drunken-octopus/ao-usb-drive-reader-rev-c/KiCad_Files/USB_Reader_Rev_C.png

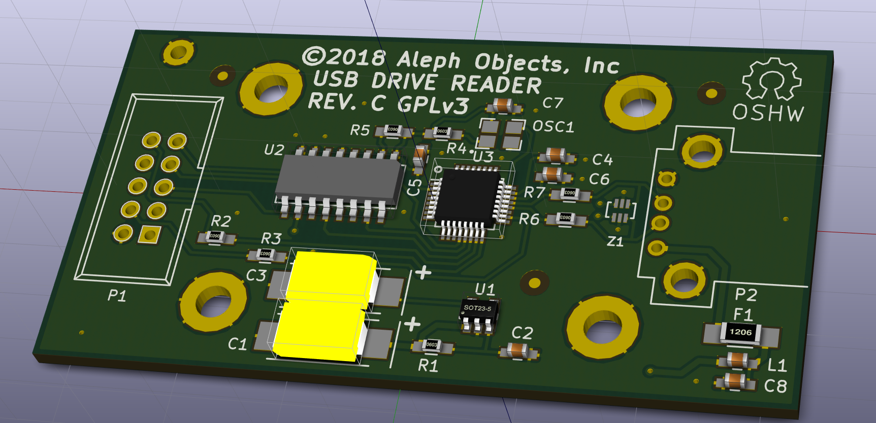
KiCad_Files/USB_Reader_Rev_C.png
