drunken-octopus/ao-usb-drive-reader-rev-c/USB_Reader_Rev_C.pdf

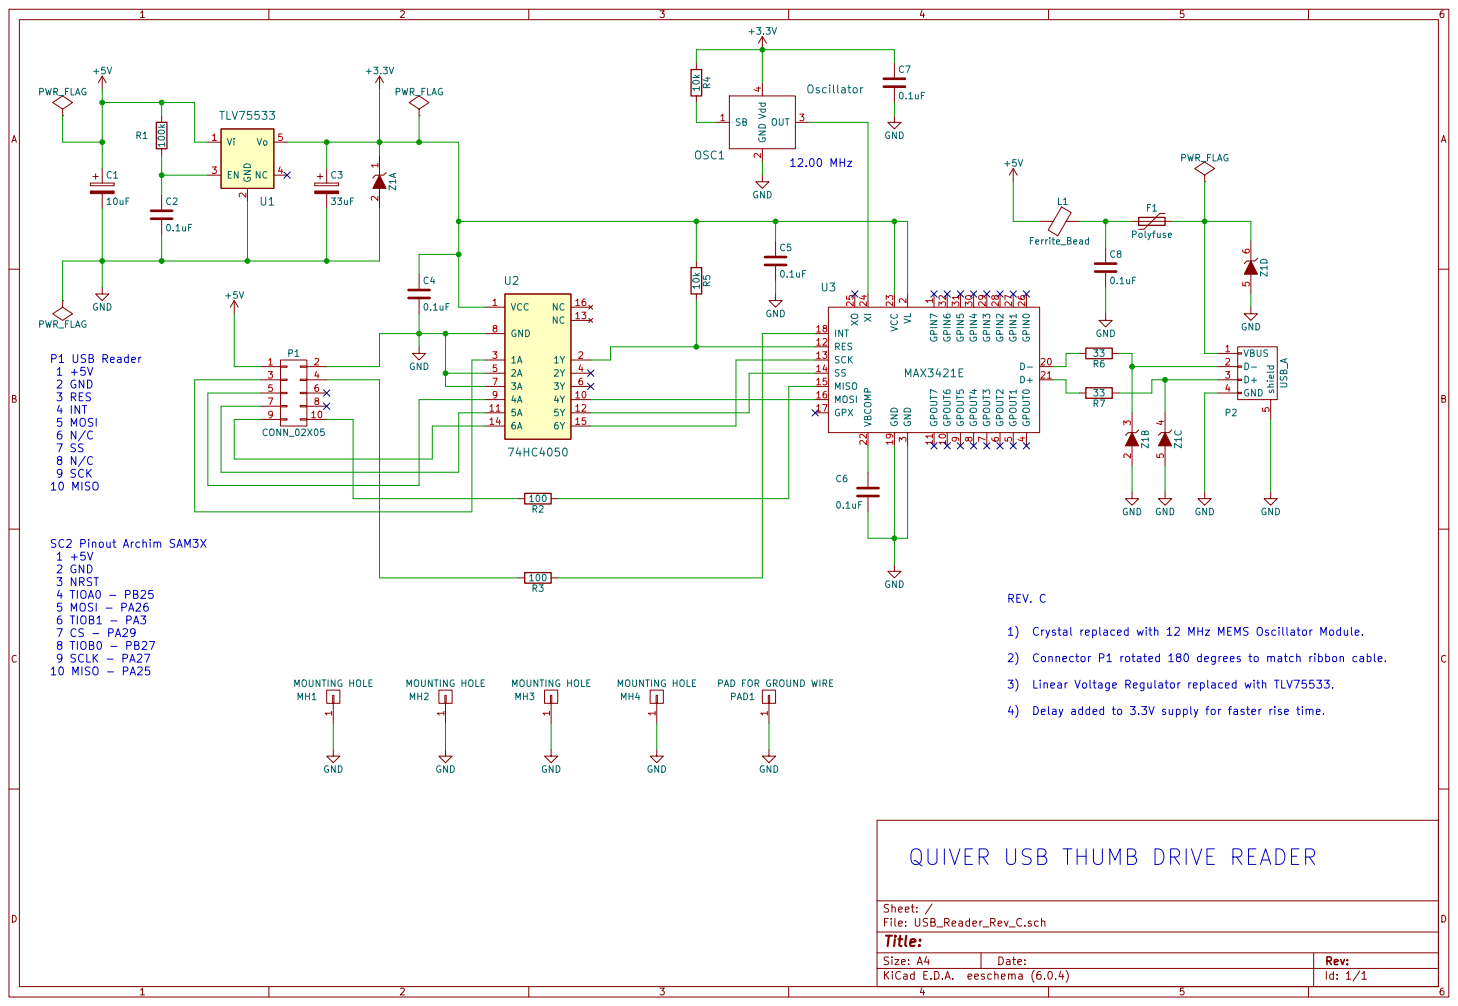
[picture p2: page 1]

1 GPOUT6 10 GPOUT7 11 RES 12 SCK 13 SS 14 MISO 15 MOSI 16 GPX 17

2 D- 20 D+ 21 VBCOMP 22 VCC 23 XI 24 XO 25 GPIN0 26 GPIN1 27 GPIN2 28 GPIN3 29 GND

3A 7 GND 8 1A 3

1 MH1 MOUNTING HOLE GND GND

1 PAD1 PAD FOR GROUND WIRE C6

1) Crystal replaced with 12 MHz MEMS Oscillator Module.

2) Connector P1 rotated 180 degrees to match ribbon cable.

3) Linear Voltage Regulator replaced with TLV75533.

4) Delay added to 3.3V supply for faster rise time.

QUIVER USB THUMB DRIVE READER
