drunken-octopus/ao-usb-drive-reader-rev-c/KiCad_Files/USB_Reader_Rev_C.kicad_pcb

## KiCad design KiCad_Files/USB_Reader_Rev_C.kicad_pcb (2019-01-10)

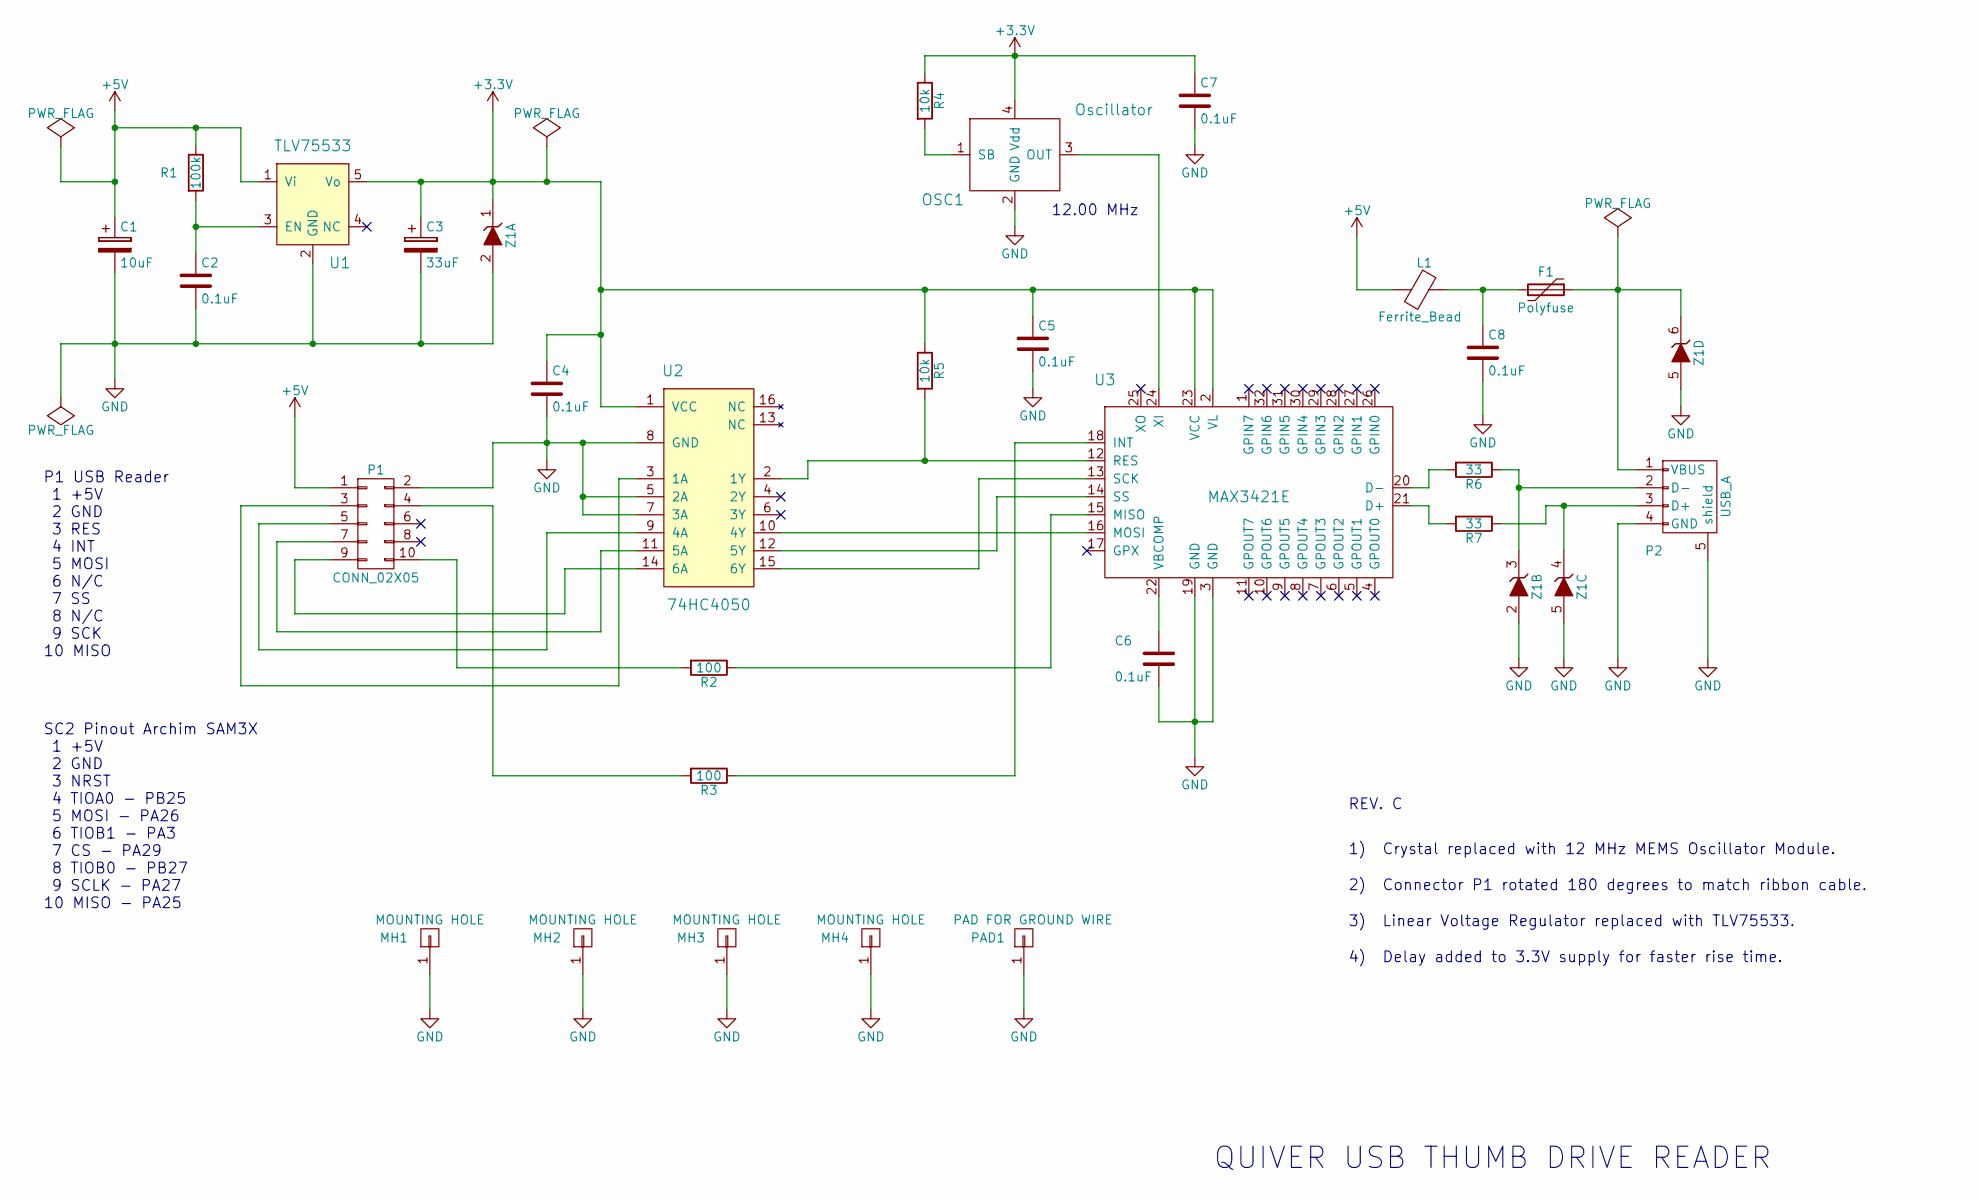
[picture p3: schematic USB_Reader_Rev_C.sch]

Parts:
C1: 10uF; TantalC_SizeD_EIA-7343_HandSoldering
C2, C4, C5, C6, C7, C8: 0.1uF; C_0603_HandSoldering
C3: 33uF; TantalC_SizeD_EIA-7343_HandSoldering
F1: Polyfuse; R_1206_HandSoldering
L1: Ferrite_Bead; C_0603_HandSoldering
MH1, MH2, MH3, MH4: MOUNTING HOLE; MH_M3x6mm
OSC1: Oscillator; FA-328_Crystal
P1: CONN_02X05; IDC_Header_Straight_10pins
P2: USB_A; USB_A_TH
PAD1: PAD FOR GROUND WIRE; GND_PAD
R1: 100k; R_0603_HandSoldering
R2, R3: 100; R_0603_HandSoldering
R4, R5: 10k; R_0603_HandSoldering
R6, R7: 33; R_0603_HandSoldering
U1: TLV75533; SOT-23-5
U2: 74HC4050; SO-16-N
U3: MAX3421E; LQFP-32_5x5mm_Pitch0.5mm
Z1: ZENER_4_CHANNEL; SOT-666

Connections:
+3V3: C3.1, C4.1, C5.1, C7.1, OSC1.4 (Vdd), R4.1, R5.1, U1.5 (Vo), U2.1 (VCC), U3.2 (VL), U3.23 (VCC), Z1.1 (K)
+5V: C1.1, L1.2, P1.1, R1.1, U1.1 (Vi)
GND: C1.2, C2.2, C3.2, C4.2, C5.2, C6.2, C7.2, C8.2, MH1.1, MH2.1, MH3.1, MH4.1, OSC1.2 (GND), P1.2, P2.4 (GND), P2.5 (shield), PAD1.1, U1.2 (GND), U2.5 (2A), U2.7 (3A), U2.8 (GND), U3.3 (GND), U3.19 (GND), Z1.2 (A), Z1.5 (A)
unnamed: C2.1, R1.2, U1.3 (EN)
unnamed: C6.1, U3.22 (VBCOMP)
unnamed: C8.1, F1.2, L1.1
unnamed: F1.1, P2.1 (VBUS), Z1.6 (K)
unnamed: OSC1.1 (SB), R4.2
unnamed: OSC1.3 (OUT), U3.24 (XI)
unnamed: P1.3, U2.3 (1A)
unnamed: P1.4, R3.2
unnamed: P1.5, U2.9 (4A)
unnamed: P1.7, U2.11 (5A)
unnamed: P1.9, U2.14 (6A)
unnamed: P1.10, R2.2
unnamed: P2.2 (D-), R6.1, Z1.3 (K)
unnamed: P2.3 (D+), R7.1, Z1.4 (K)
unnamed: R2.1, U3.15 (MISO)
unnamed: R3.1, U3.18 (INT)
unnamed: R5.2, U2.2 (1Y), U3.12 (RES)
unnamed: R6.2, U3.20 (D-)
unnamed: R7.2, U3.21 (D+)
unnamed: U2.10 (4Y), U3.16 (MOSI)
unnamed: U2.12 (5Y), U3.14 (SS)
unnamed: U2.15 (6Y), U3.13 (SCK)

Notes on the sheet:
QUIVER USB THUMB DRIVE READER
SC2 Pinout Archim SAM3X 1 +5V 2 GND 3 NRST 4 TIOA0 - PB25 5 MOSI - PA26 6 TIOB1 - PA3 7 CS - PA29 8 TIOB0 - PB27 9 SCLK - PA27 10 MISO - PA25
P1 USB Reader 1 +5V 2 GND 3 RES 4 INT 5 MOSI 6 N/C 7 SS 8 N/C 9 SCK 10 MISO
REV. C
1) Crystal replaced with 12 MHz MEMS Oscillator Module.
2) Connector P1 rotated 180 degrees to match ribbon cable.
12.00 MHz
3) Linear Voltage Regulator replaced with TLV75533.
4) Delay added to 3.3V supply for faster rise time.

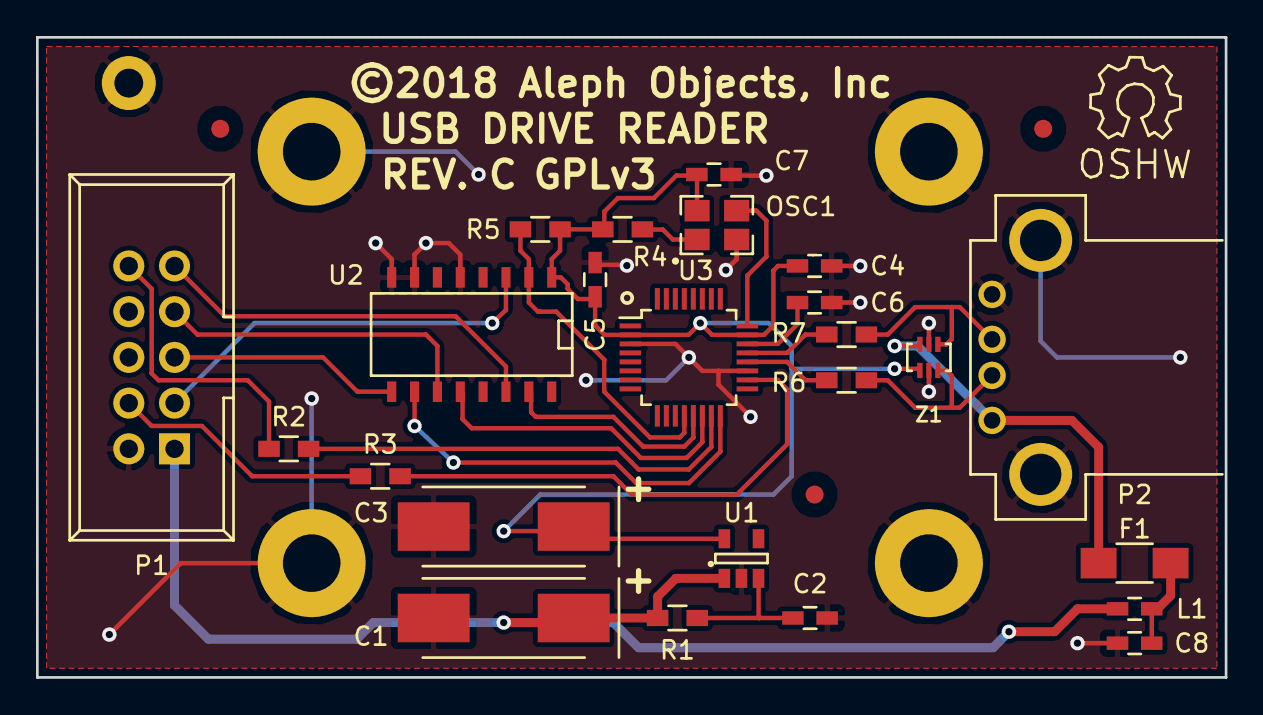
[picture p4: board USB_Reader_Rev_C.kicad_pcb from above]

Board: 2 copper layers, 66.0 x 35.6 mm, 29 parts (0 on the bottom side), 25 nets.
