drunken-octopus/ao-usb-drive-reader-rev-c/(commit log)

2018-02-20 KiCad and Gerber files added for the first time to the repo.
    [USB_Reader-B.Cu.gbr, USB_Reader-B.Mask.gbr, USB_Reader-Edge.Cuts.gbr, USB_Reader-F.Cu.gbr, USB_Reader-F.Mask.gbr, USB_Reader-F.Paste.gbr, USB_Reader-F.SilkS.gbr, USB_Reader.drl]
2018-08-24 Added REV A Gerbers
    [USB_Reader-B.Cu.gbr, USB_Reader-B.Mask.gbr, USB_Reader-Edge.Cuts.gbr, USB_Reader-F.Cu.gbr, USB_Reader-F.Mask.gbr, USB_Reader-F.Paste.gbr, USB_Reader-F.SilkS.gbr, USB_Reader.drl]
2018-08-24 Added REV A KiCad Files
    [USB_Reader.kicad_pcb, USB_Reader.sch]
2018-08-24 Removed REV A files
    [USB_Reader-B.Cu.gbr, USB_Reader-B.Mask.gbr, USB_Reader-Edge.Cuts.gbr, USB_Reader-F.Cu.gbr, USB_Reader-F.Mask.gbr, USB_Reader-F.Paste.gbr, USB_Reader-F.SilkS.gbr, USB_Reader.drl]
2018-08-24 Added REV B files
    [USB_Reader-B.Cu.gbr, USB_Reader-B.Mask.gbr, USB_Reader-Edge.Cuts.gbr, USB_Reader-F.Cu.gbr, USB_Reader-F.Mask.gbr, USB_Reader-F.Paste.gbr, USB_Reader-F.SilkS.gbr, USB_Reader.drl]
2018-10-29 C5 and C7 changed to 18pF on BOM
2018-11-21 Changed value of C5 and C7 to 18pF.
    [USB_Reader.sch]
2018-11-26 Updated schematic pdf to show C5 and C7 as 18pF
2018-12-28 All board files updated to Rev. C
    [USB_Reader.kicad_pcb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]
2019-01-10 OSHW mark added to PCB silk.
    [USB_Reader_Rev_C.kicad_pcb]
2023-07-22 Added PDF version of schematics
