drunken-octopus/ao-usb-drive-reader-rev-c/(notices)

Notices in the files:
KiCad_Files/USB_Reader_Rev_C.kicad_pcb:
GPLv3
©2018 Aleph Objects, Inc
